casartar/LoRaWAN-Sensor/README.md

# Das LoRaWAN Sensor Projekt vom ZTL.space

[TTN](Documentation/TTN.md)

[Cayenne](Documentation/Cayenne.md)

[Assembly](Documentation/Assembly.md)
