casartar/LoRaWAN-Sensor/Documentation/Cayenne.md

# myDevices Cayenne Dashboard
[Cayenne Dashboard](https://cayenne.mydevices.com/)

1. Register

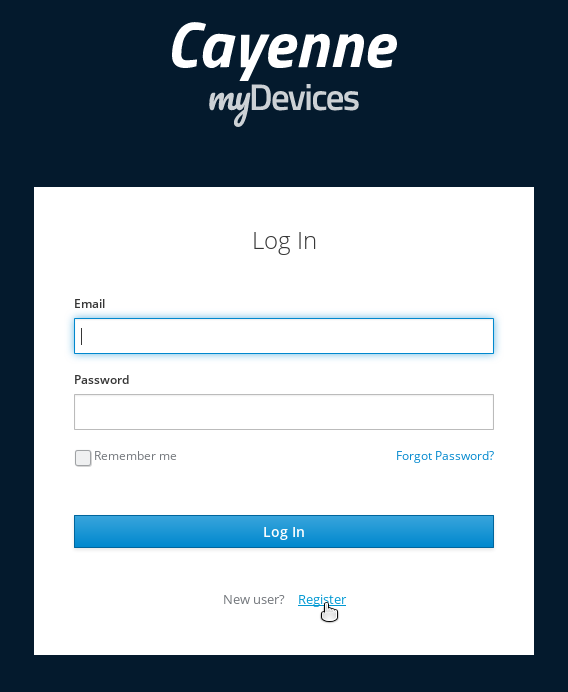
[picture p1: Documentation/Pictures_Cayenne/Screenshot_20201028_194106.png]
CAYENNE1


2. Vorname, Nachmane, Email-Adresse und Passwort vergeben. Mit Register bestätigen:

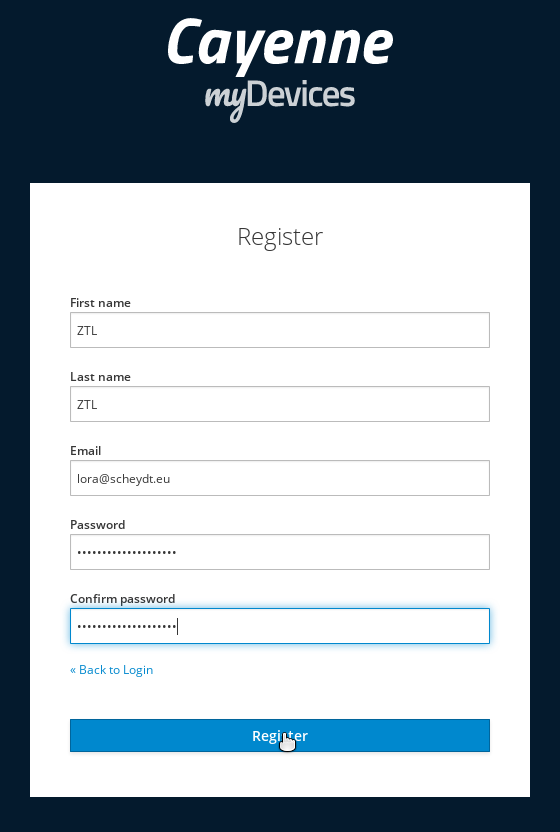
[picture p2: Documentation/Pictures_Cayenne/Screenshot_20201028_194218.png]
CAYENNE1


3. LoRA auswählen

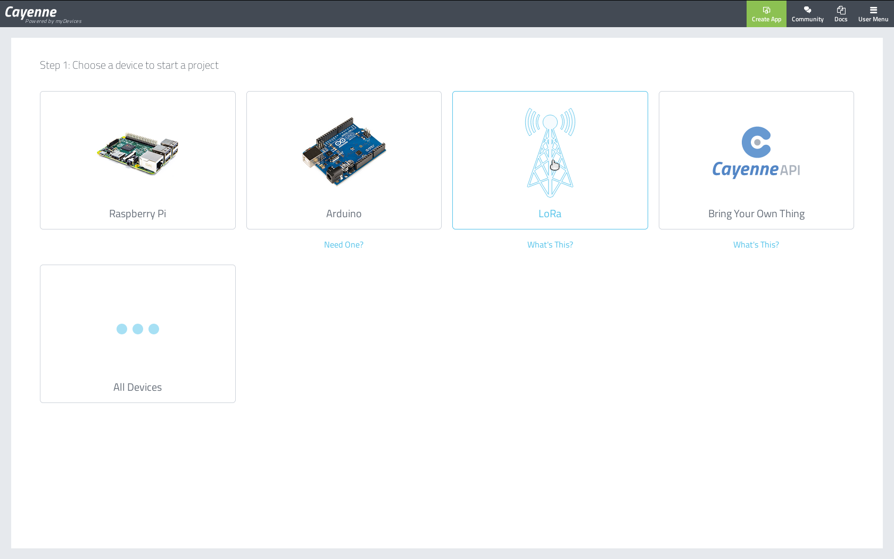
[picture p3: Documentation/Pictures_Cayenne/Screenshot_20201028_194320.png]
CAYENNE1


4. In der Liste links "The Thingnetwork" auswählen:

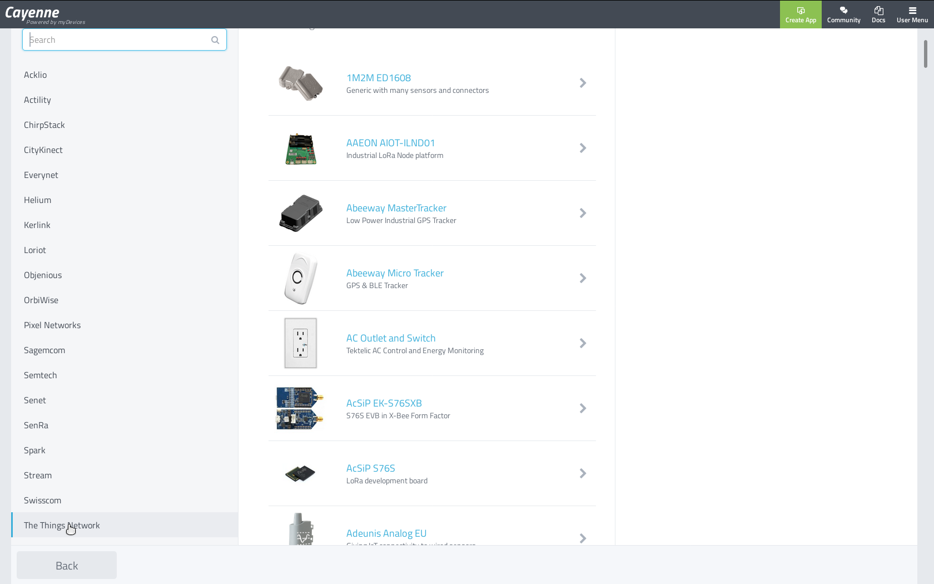
[picture p4: Documentation/Pictures_Cayenne/Screenshot_20201028_200921.png]
CAYENNE1


5. Dann nach "LPP" suchen und "Cayenne LPP" auswählen:

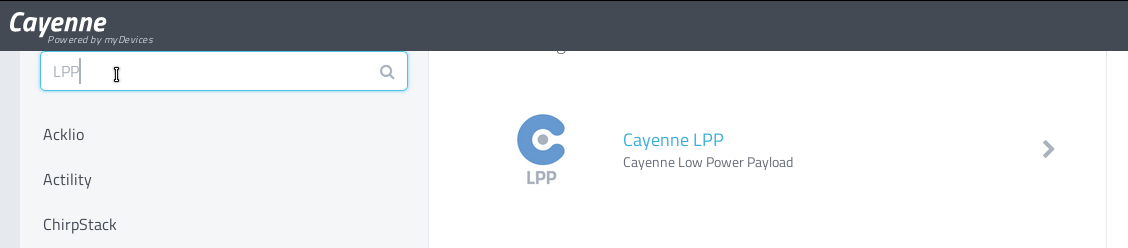
[picture p5: Documentation/Pictures_Cayenne/Screenshot_20201028_200932.png]
CAYENNE1


6. Aus dem TTN die Device EUI in hex format kopieren.

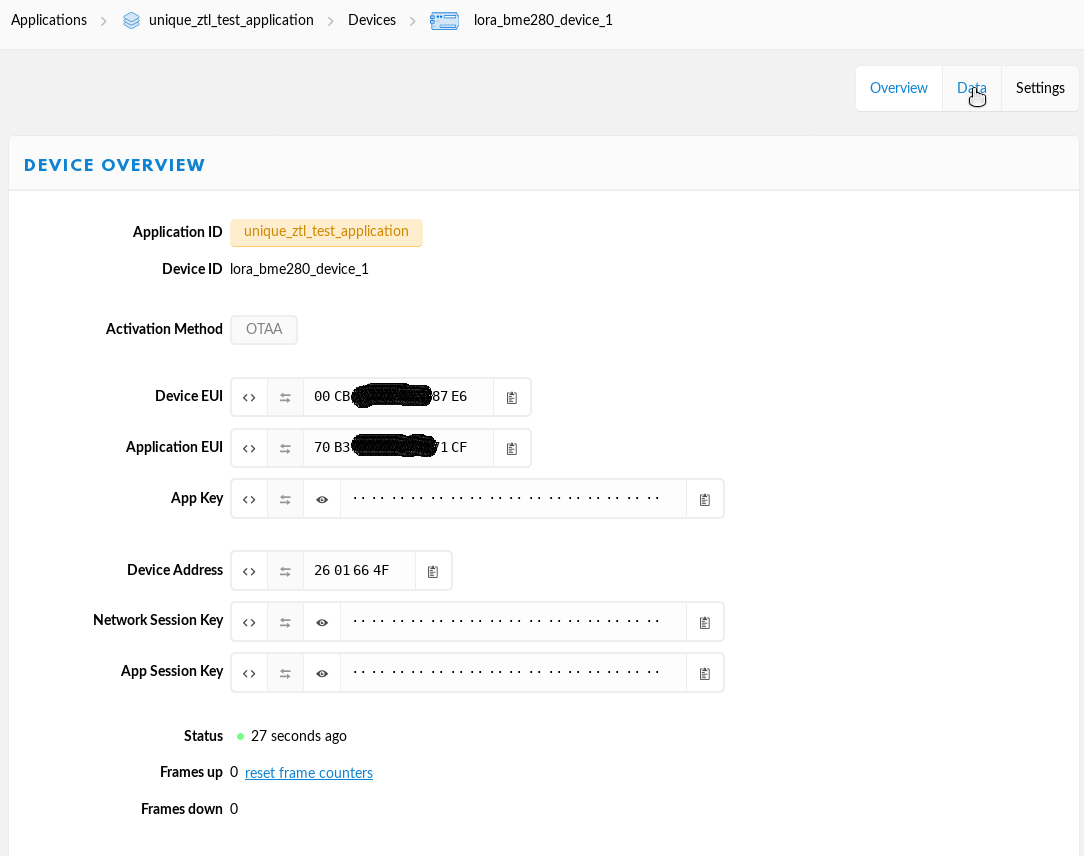
[picture p6: Documentation/Pictures_Cayenne/Screenshot_20201028_193343.png]
CAYENNE1


7. Name vergeben, die soeben kopierte Device EUI einfügen und Already Registered auswählen. Mit "Add device" bestätigen.

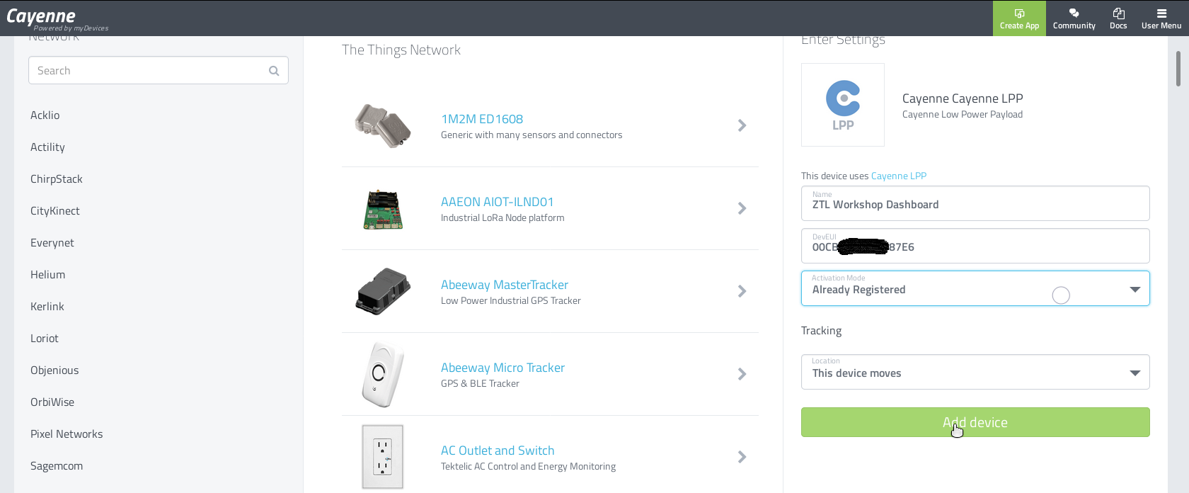
[picture p7: Documentation/Pictures_Cayenne/Screenshot_20201028_201020.png]
CAYENNE1


8. Sobald die ersten Daten empfangen werden, baut sich das Dashboard von selbst auf:

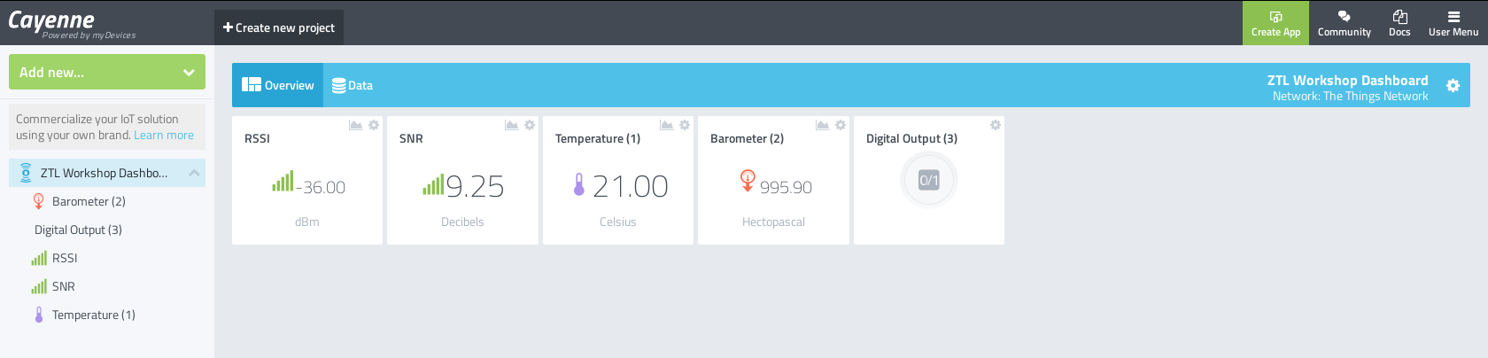
[picture p8: Documentation/Pictures_Cayenne/Screenshot_20201028_201038.png]
CAYENNE1


Mit einem Klick auf Digital Output kann die LED am Sensor aktiviert werden. Diese Information wird jedoch erst zum Sensor übertragen, nachdem dieser Seinerseits Daten übertragen hat.
