casartar/LoRaWAN-Sensor/Documentation/Pictures_Cayenne/Screenshot_20201028_200942.png

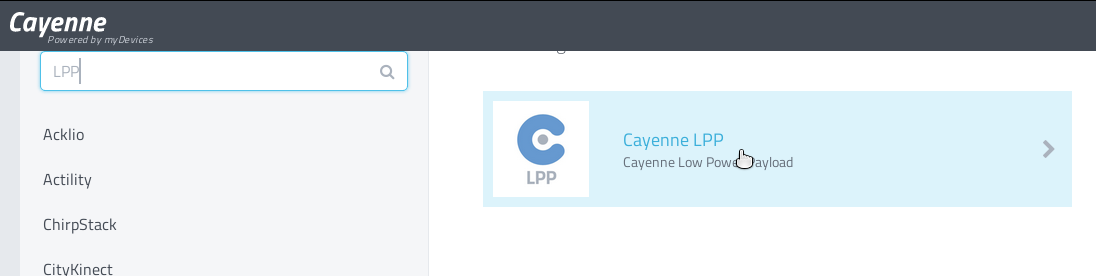
Documentation/Pictures_Cayenne/Screenshot_20201028_200942.png
