casartar/LoRaWAN-Sensor/Documentation/Pictures_TTN/Screenshot_20201028_191531.png

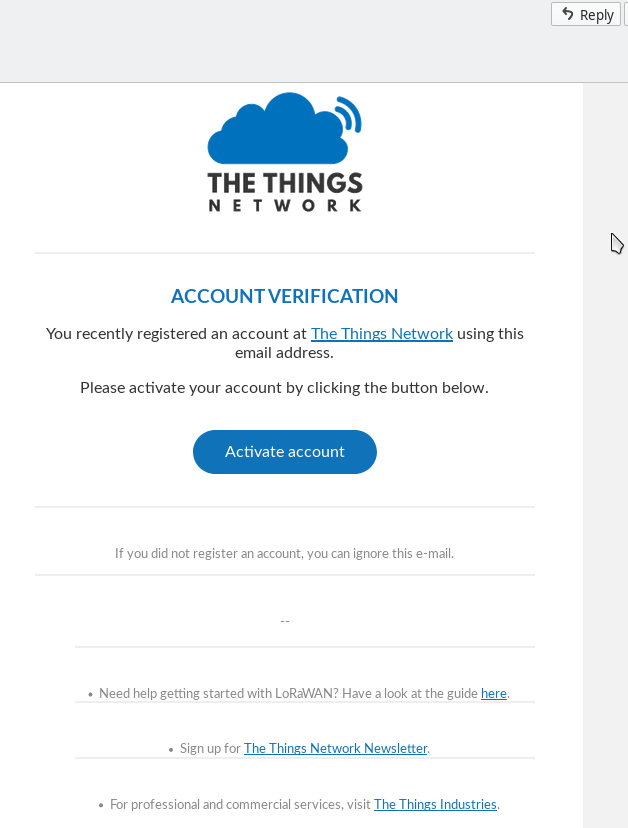
Documentation/Pictures_TTN/Screenshot_20201028_191531.png
