casartar/LoRaWAN-Sensor/Documentation/Pictures_TTN/Screenshot_20201028_193413.png

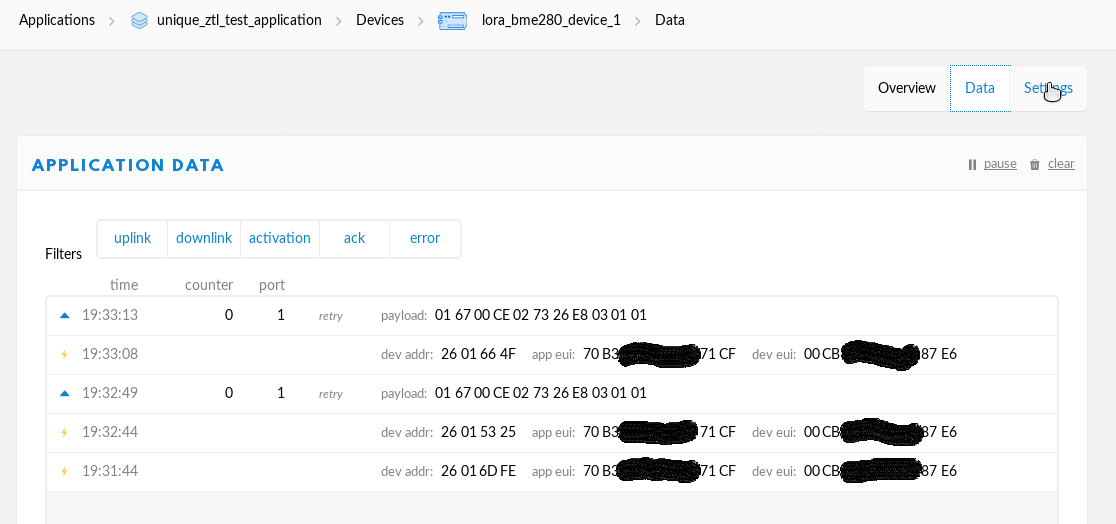
Documentation/Pictures_TTN/Screenshot_20201028_193413.png
