casartar/LoRaWAN-Sensor/3D-Models/LoRa-Baseplate.FCStd

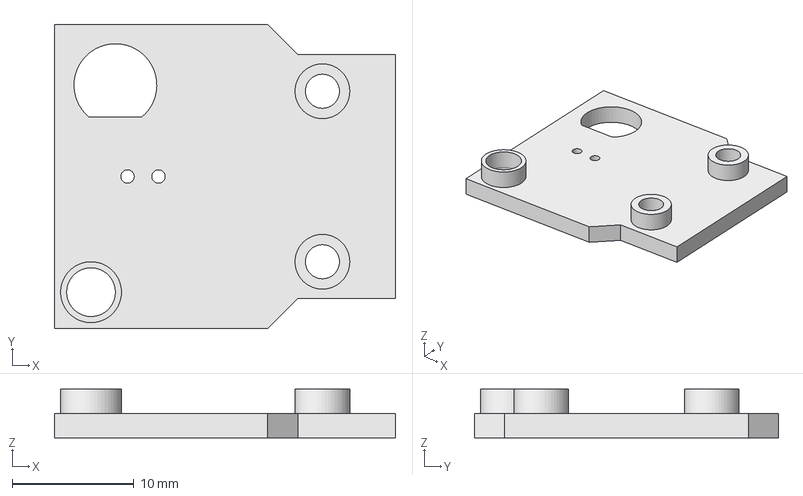
[picture p33: CAD file, 2020-11-08]
3D-Models/LoRa-Baseplate.FCStd
28.0 x 25.0 x 4.00 mm
