casartar/LoRaWAN-Sensor/(list of files, cad)

Other CAD files:
3D-Models/LoRa-Baseplate.stl
