casartar/LoRaWAN-Sensor/Documentation/Assembly.md

# Zusammenbau der Hardware

1. Alle Bauteile

* BME 280 mit Stiftleiste
*  Baseplate
*  WIFI LoRa 32 (V2) mit Stiftleisten
*  Pigtail
*  Antenne
*  LED
*  2x Unterlegscheiben M2
*  2x Schrauben M2 8 mm
*  1x Mutter M3
*  1x Schraube M3 8 mm
*  6x Jumper Kabel Female-Female

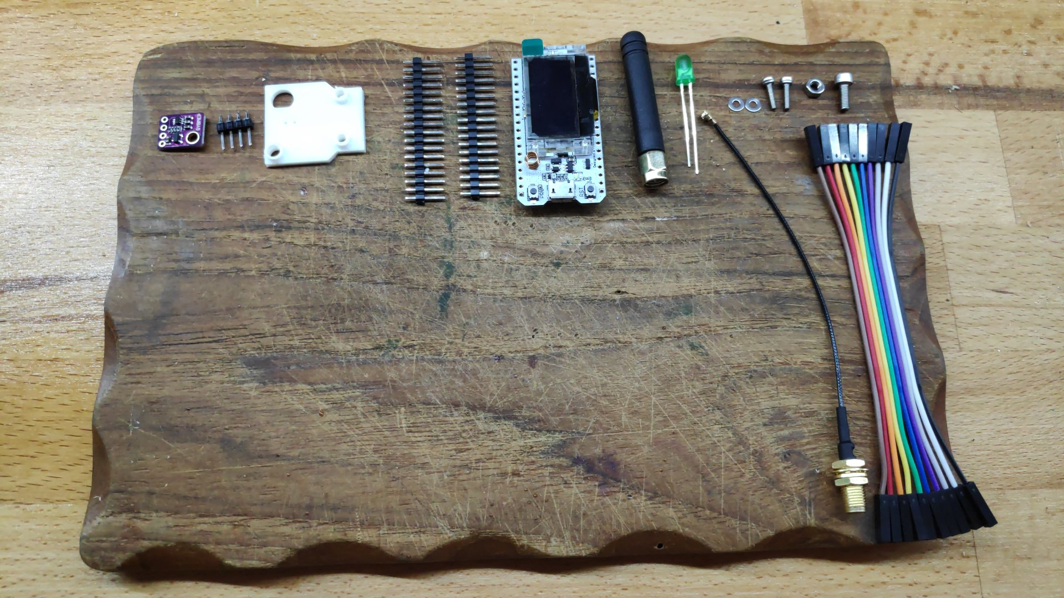
[picture p34: Documentation/Pictures_Assembly/IMG_20201108_200519.jpg]
ASSEMBLY


2. Beide Stifleisten an WIFI LoRa 32 (V2) anlöten.

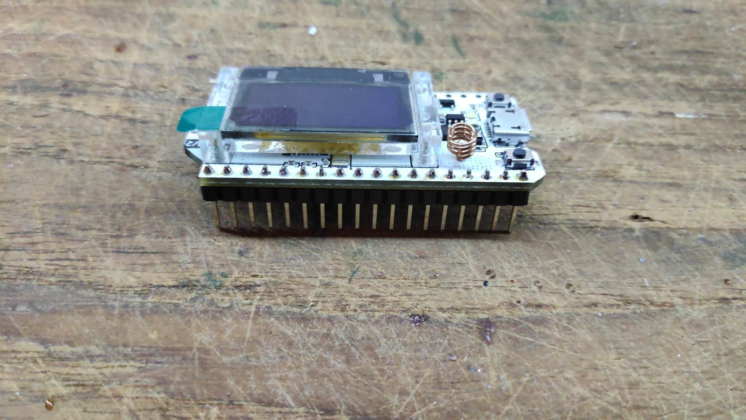
[picture p35: Documentation/Pictures_Assembly/IMG_20201108_200737.jpg]
ASSEMBLY


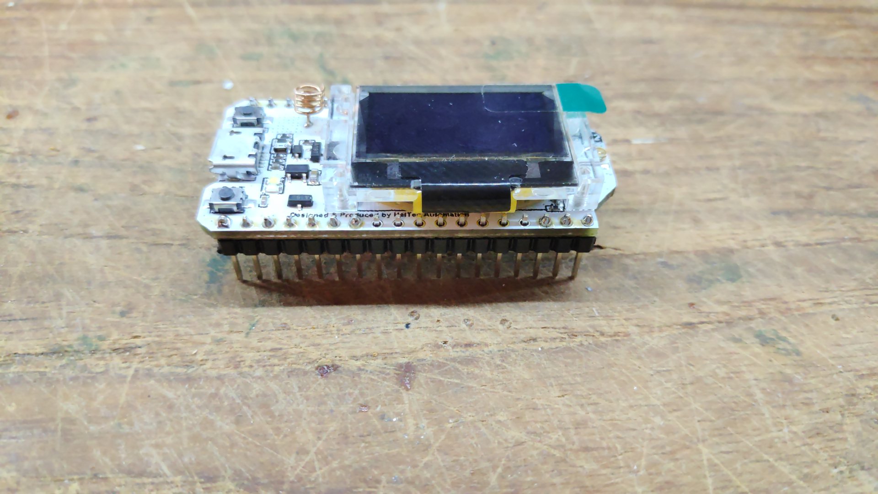
[picture p36: Documentation/Pictures_Assembly/IMG_20201108_200853.jpg]
ASSEMBLY


3. Zwei Schrauben für Displayhalterung entfernen.

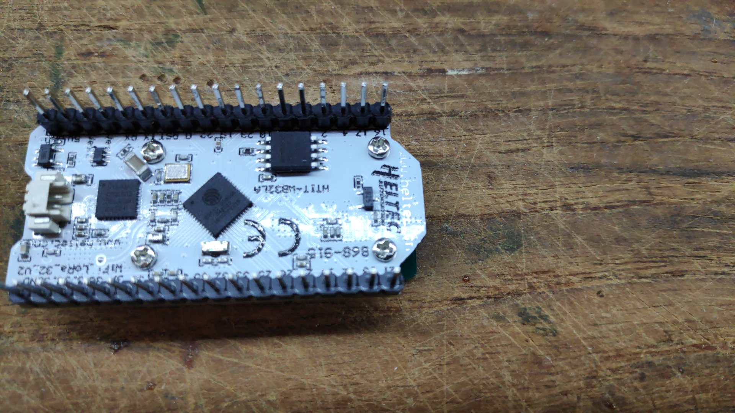
[picture p37: Documentation/Pictures_Assembly/IMG_20201108_201014.jpg]
ASSEMBLY


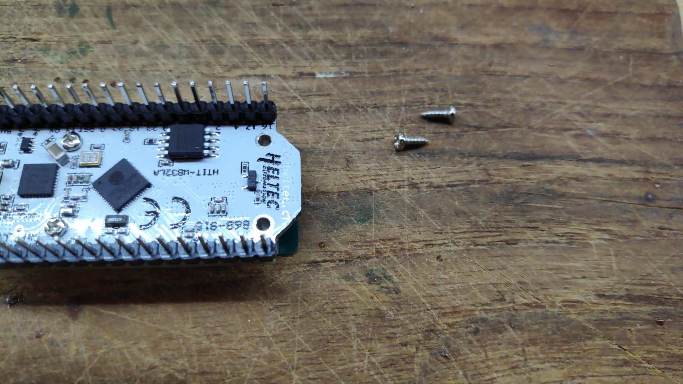
[picture p38: Documentation/Pictures_Assembly/IMG_20201108_201040.jpg]
ASSEMBLY


4. Baseplate mit M2 Schrauben und Unterlegscheiben fixieren. 

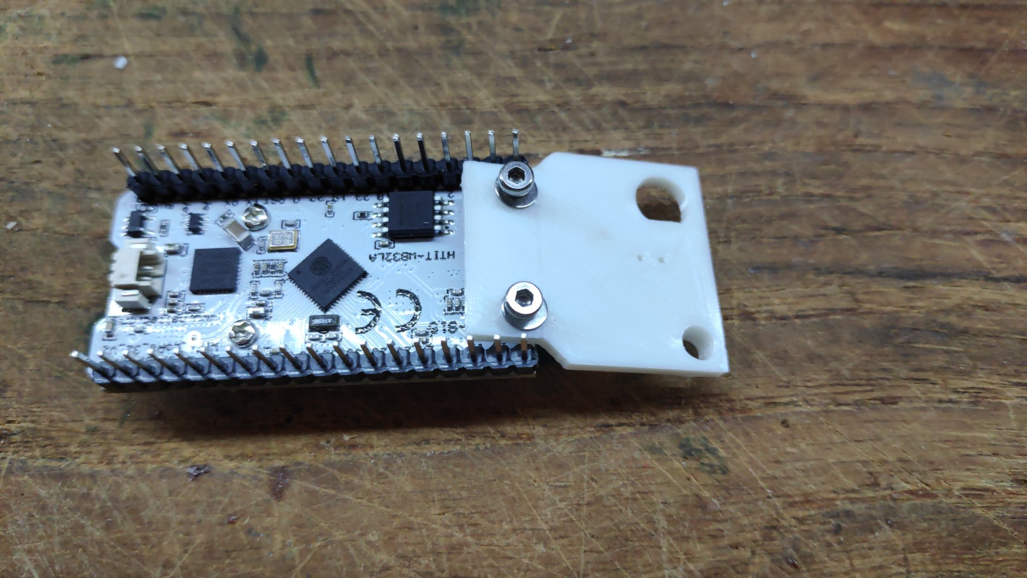
[picture p39: Documentation/Pictures_Assembly/IMG_20201108_201211.jpg]
ASSEMBLY


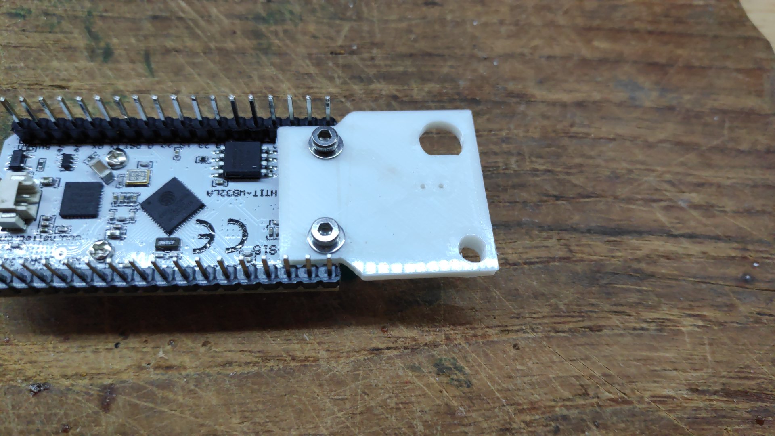
[picture p40: Documentation/Pictures_Assembly/IMG_20201108_201237.jpg]
ASSEMBLY


5. Stiftleiste an BME 280 anlöten.

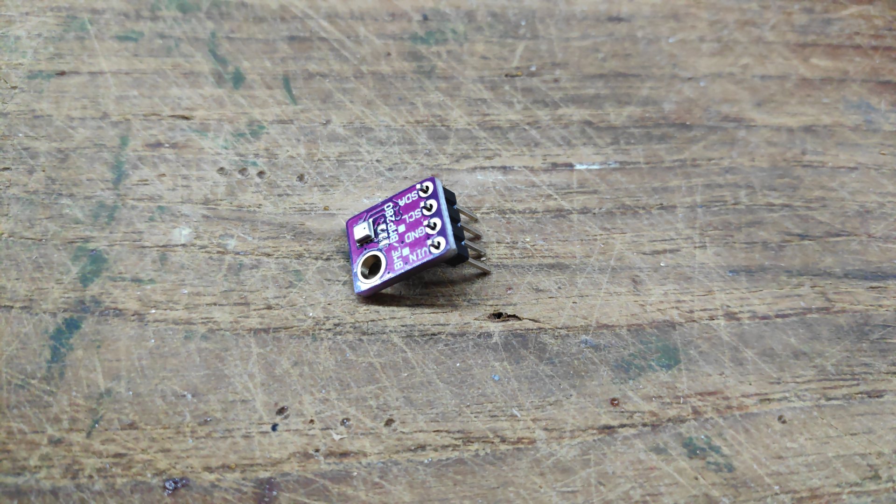
[picture p41: Documentation/Pictures_Assembly/IMG_20201108_201305.jpg]
ASSEMBLY


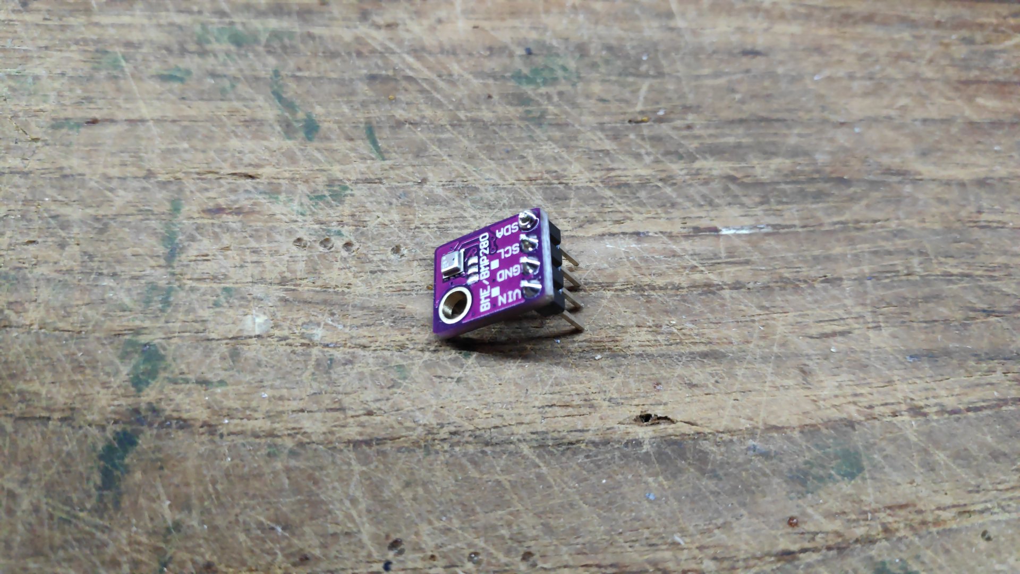
[picture p42: Documentation/Pictures_Assembly/IMG_20201108_201346.jpg]
ASSEMBLY


6. BME 280 mit M3 Schraube und Mutter fixieren.

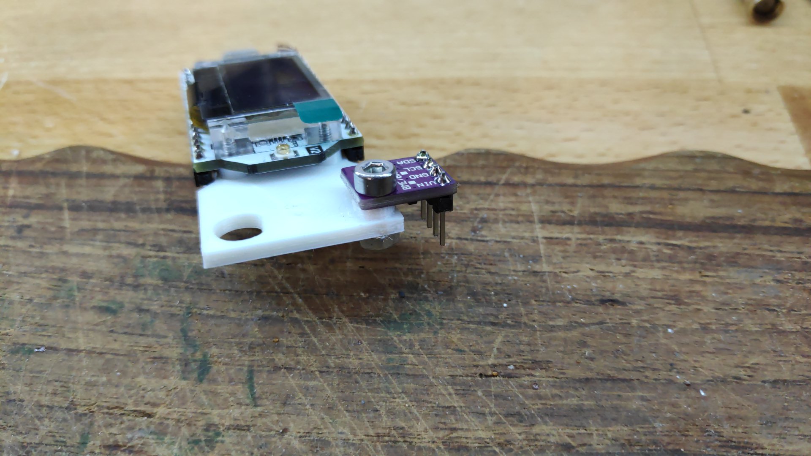
[picture p43: Documentation/Pictures_Assembly/IMG_20201108_201436.jpg]
ASSEMBLY


7. Pigtail an Baseplate festschrauben.

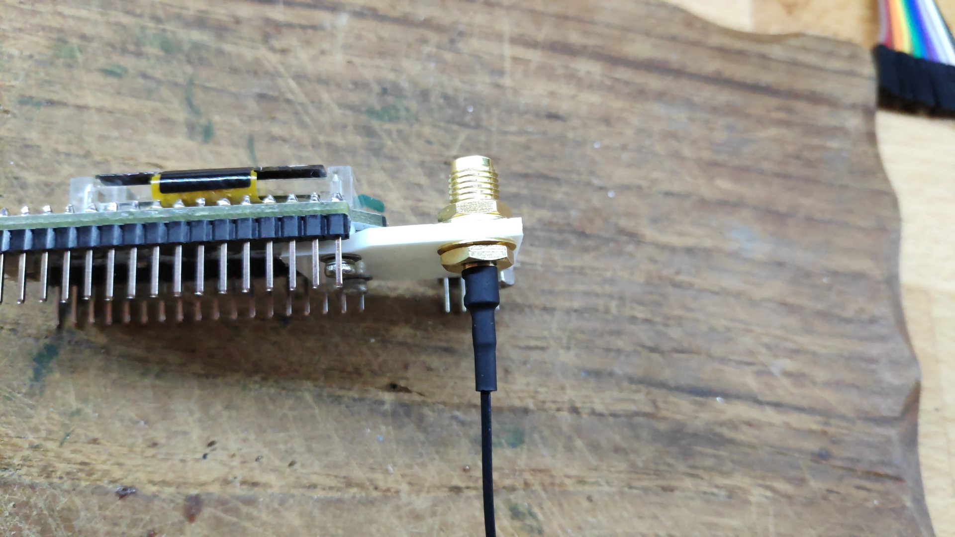
[picture p44: Documentation/Pictures_Assembly/IMG_20201108_201644.jpg]
ASSEMBLY


8. LED in Baseplate einstecken.

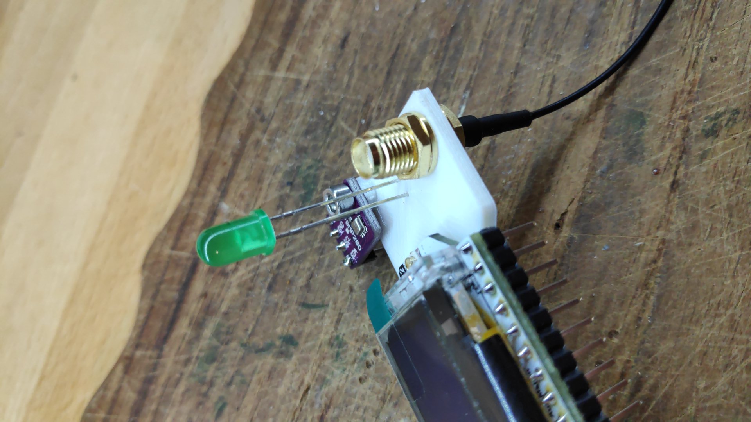
[picture p45: Documentation/Pictures_Assembly/IMG_20201108_201703.jpg]
ASSEMBLY


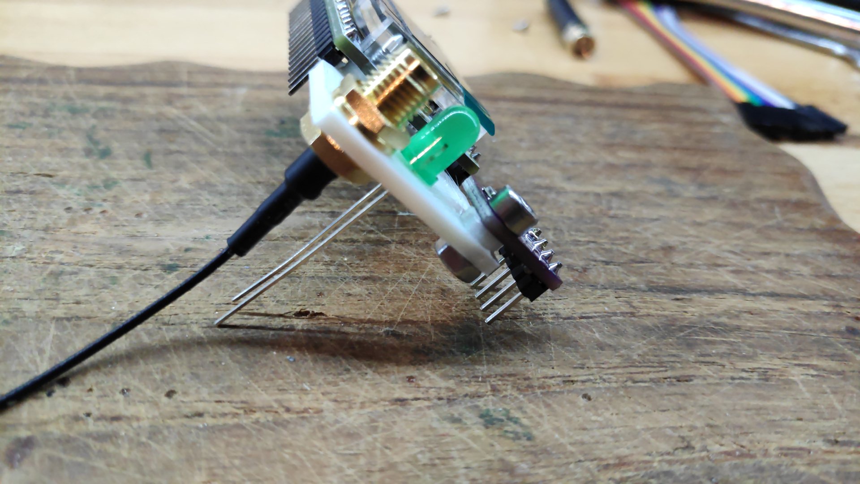
[picture p46: Documentation/Pictures_Assembly/IMG_20201108_201722.jpg]
ASSEMBLY


9. Pigtail an U.FL Stecker anschließen.

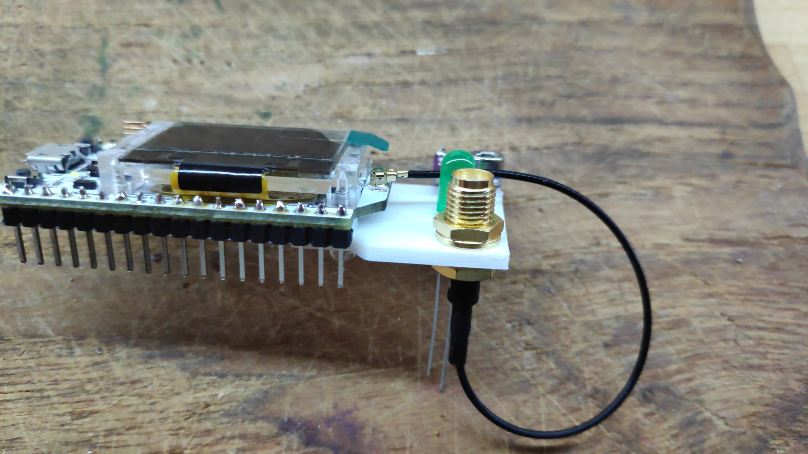
[picture p47: Documentation/Pictures_Assembly/IMG_20201108_201745.jpg]
ASSEMBLY


10. Mit Jumper Kabel LED verbinden

WIFI LoRa 32 (V2) | LED | Vorzugsfarbe
-------- | -------- | --------
Pin 17   | Anode (langer Pin)   | Orange
GND   | Kathode (kurzer Pin)   | Braun

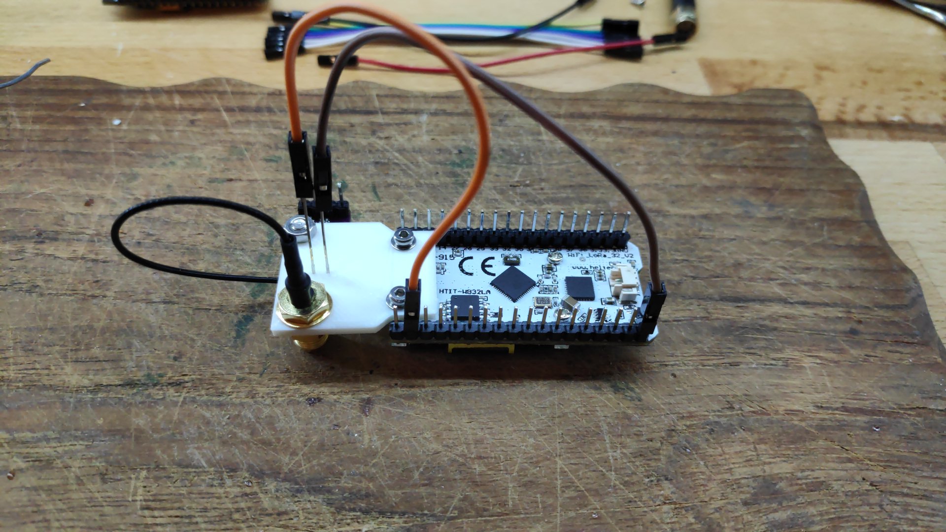
[picture p48: Documentation/Pictures_Assembly/IMG_20201108_201903.jpg]
ASSEMBLY


11. Mit Jumper Kabel BME 280 verbinden

WIFI LoRa 32 (V2) | BME280 | Vorzugsfarbe
-------- | -------- | --------
Pin 21   | SDA   | Blau
Pin 22   | SCL   | Gelb
3V3   | VIN   | Rot
GND   | GND   | Schwarz

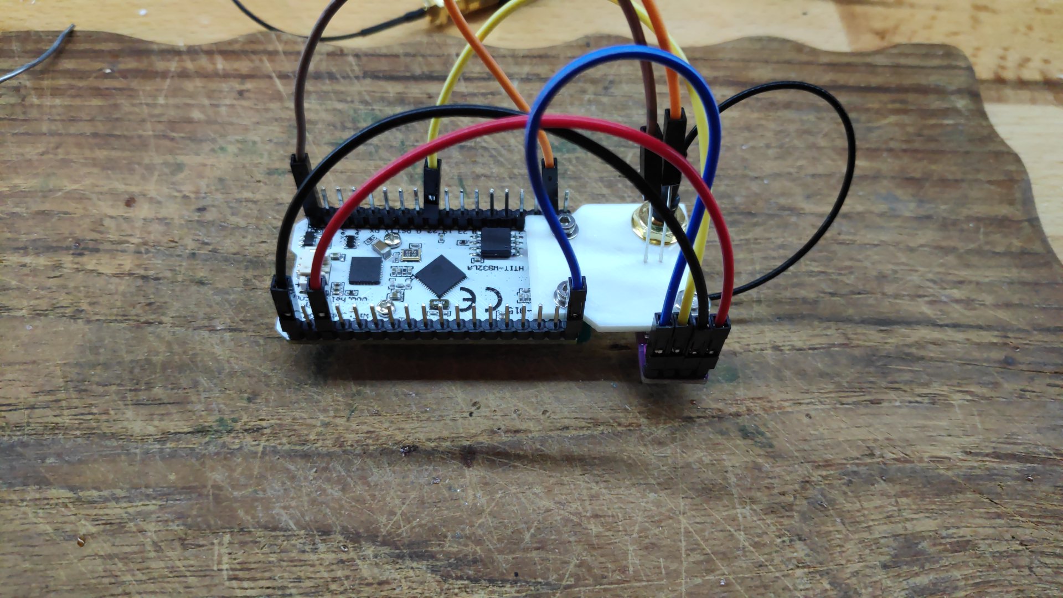
[picture p49: Documentation/Pictures_Assembly/IMG_20201108_202110.jpg]
ASSEMBLY


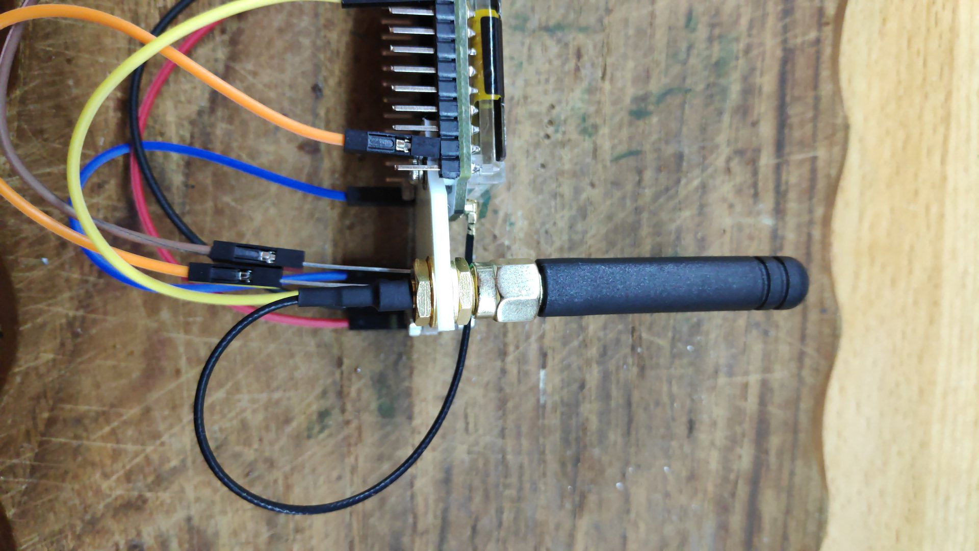
[picture p50: Documentation/Pictures_Assembly/IMG_20201108_202134.jpg]
ASSEMBLY
