casartar/LoRaWAN-Sensor/Documentation/Pictures_Assembly/IMG_20201108_200954.jpg

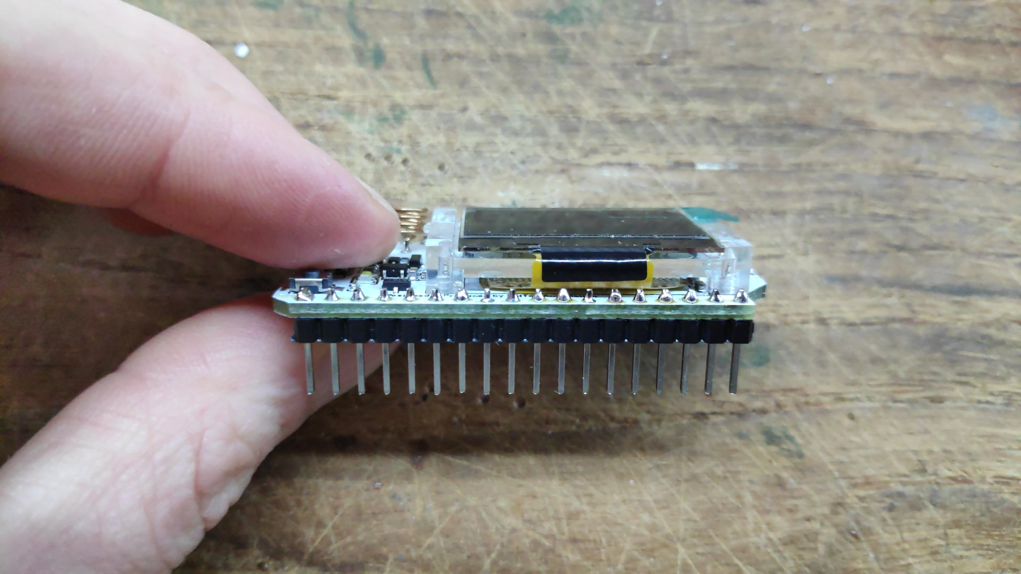
Documentation/Pictures_Assembly/IMG_20201108_200954.jpg
