casartar/LoRaWAN-Sensor/Firmware/src/main.cpp

/*******************************************************************************
 * Copyright (c) 2015 Thomas Telkamp and Matthijs Kooijman
 * Copyright (c) 2018 Terry Moore, MCCI
 *
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
 * This example sends a valid LoRaWAN packet with payload "Hello,
 * world!", using frequency and encryption settings matching those of
 * the The Things Network.
 *
 * This uses OTAA (Over-the-air activation), where where a DevEUI and
 * application key is configured, which are used in an over-the-air
 * activation procedure where a DevAddr and session keys are
 * assigned/generated for use with all further communication.
 *
 * Note: LoRaWAN per sub-band duty-cycle limitation is enforced (1% in
 * g1, 0.1% in g2), but not the TTN fair usage policy (which is probably
 * violated by this sketch when left running for longer)!

 * To use this sketch, first register your application and device with
 * the things network, to set or generate an AppEUI, DevEUI and AppKey.
 * Multiple devices can use the same AppEUI, but each device has its own
 * DevEUI and AppKey.
 *
 * Do not forget to define the radio type correctly in
 * arduino-lmic/project_config/lmic_project_config.h or from your BOARDS.txt.
 *
 *******************************************************************************/
#include <Arduino.h>

// LoRa
#include <lmic.h>
#include <hal/hal.h>
#include <SPI.h>

// BMP280
#include <Wire.h>
#include "Adafruit_BME280.h"

//CayenneLPP
#include <CayenneLPP.h>

// OLED
//#include <U8x8lib.h>
#include <U8g2lib.h>

#include "defines.h"

// This EUI must be in little-endian format, so least-significant-byte
// first. When copying an EUI from ttnctl output, this means to reverse
// the bytes. For TTN issued EUIs the last bytes should be 0xD5, 0xB3,
// 0x70.
static const u1_t PROGMEM APPEUI[8] = DEF_APPEUI;
void os_getArtEui (u1_t* buf) { memcpy_P(buf, APPEUI, 8);}

// This should also be in little endian format, see above.
static const u1_t PROGMEM DEVEUI[8] = DEF_DEVEUI;
void os_getDevEui (u1_t* buf) { memcpy_P(buf, DEVEUI, 8);}

// This key should be in big endian format (or, since it is not really a
// number but a block of memory, endianness does not really apply). In
// practice, a key taken from ttnctl can be copied as-is.
static const u1_t PROGMEM APPKEY[16] = DEF_APPKEY;
void os_getDevKey (u1_t* buf) {  memcpy_P(buf, APPKEY, 16);}

static osjob_t sendjob;

// Schedule TX every this many seconds (might become longer due to duty
// cycle limitations).
const unsigned TX_INTERVAL = 60;

// Pin mapping
const lmic_pinmap lmic_pins = {
    .nss = 18,
    .rxtx = LMIC_UNUSED_PIN,
    .rst = 14,
    .dio = {26, 35, 34},
};

#define I2C_SDA 21
#define I2C_SCL 22
#define SEALEVELPRESSURE_HPA (1013.25)
#define BME280_ADD 0x76

Adafruit_BME280 bme(I2C_SDA, I2C_SCL);

CayenneLPP lpp(51);

// OLED Pins
#define OLED_SCL 15   // GPIO 15
#define OLED_SDA  4   // GPIO  4
#define OLED_RST 16   // GPIO 16

// define the display type that we use
U8X8_SSD1306_128X64_NONAME_SW_I2C u8x8(/* clock=*/ OLED_SCL, /* data=*/ OLED_SDA, /* reset=*/ OLED_RST);

void do_send(osjob_t* j);

void printHex2(unsigned v) {
    v &= 0xff;
    if (v < 16)
        Serial.print('0');
    Serial.print(v, HEX);
}

void onEvent (ev_t ev) {
    Serial.print(os_getTime());
    Serial.print(": ");
    switch(ev) {
        case EV_SCAN_TIMEOUT:
            Serial.println(F("EV_SCAN_TIMEOUT"));
            break;
        case EV_BEACON_FOUND:
            Serial.println(F("EV_BEACON_FOUND"));
            break;
        case EV_BEACON_MISSED:
            Serial.println(F("EV_BEACON_MISSED"));
            break;
        case EV_BEACON_TRACKED:
            Serial.println(F("EV_BEACON_TRACKED"));
            break;
        case EV_JOINING:
            Serial.println(F("EV_JOINING"));
            break;
        case EV_JOINED:
            Serial.println(F("EV_JOINED"));
            {
              u4_t netid = 0;
              devaddr_t devaddr = 0;
              u1_t nwkKey[16];
              u1_t artKey[16];
              LMIC_getSessionKeys(&netid, &devaddr, nwkKey, artKey);
              Serial.print("netid: ");
              Serial.println(netid, DEC);
              Serial.print("devaddr: ");
              Serial.println(devaddr, HEX);
              Serial.print("AppSKey: ");
              for (size_t i=0; i<sizeof(artKey); ++i) {
                if (i != 0)
                  Serial.print("-");
                printHex2(artKey[i]);
              }
              Serial.println("");
              Serial.print("NwkSKey: ");
              for (size_t i=0; i<sizeof(nwkKey); ++i) {
                      if (i != 0)
                              Serial.print("-");
                      printHex2(nwkKey[i]);
              }
              Serial.println();
            }
            // Disable link check validation (automatically enabled
            // during join, but because slow data rates change max TX
	    // size, we don't use it in this example.
            LMIC_setLinkCheckMode(0);
            break;
        /*
        || This event is defined but not used in the code. No
        || point in wasting codespace on it.
        ||
        || case EV_RFU1:
        ||     Serial.println(F("EV_RFU1"));
        ||     break;
        */
        case EV_JOIN_FAILED:
            Serial.println(F("EV_JOIN_FAILED"));
            break;
        case EV_REJOIN_FAILED:
            Serial.println(F("EV_REJOIN_FAILED"));
            break;
        case EV_TXCOMPLETE:
            Serial.println(F("EV_TXCOMPLETE (includes waiting for RX windows)"));
            if (LMIC.txrxFlags & TXRX_ACK)
                Serial.println(F("Received ack"));
            if (LMIC.dataLen) {
                Serial.print(F("Received "));
                Serial.print(LMIC.dataLen);
                Serial.println(F(" bytes of payload"));
                for (uint8_t i = 0; i < LMIC.dataLen; i++) {
                    char buffer[6];
                    sprintf(buffer, "0x%02x ", LMIC.frame[LMIC.dataBeg + i]);
                    Serial.print(buffer);
                }
                Serial.println("");
                if (LMIC.frame[LMIC.dataBeg + 0] == 0x03
                 && LMIC.frame[LMIC.dataBeg + 1] == 0x00) {
                    if (LMIC.frame[LMIC.dataBeg + 2] == 0x64) {
                        digitalWrite(17, HIGH);
                    }
                    else if (LMIC.frame[LMIC.dataBeg + 2] == 0x00) {
                        digitalWrite(17, LOW);
                    }
                }
            }
            // Schedule next transmission
            os_setTimedCallback(&sendjob, os_getTime()+sec2osticks(TX_INTERVAL), do_send);
            break;
        case EV_LOST_TSYNC:
            Serial.println(F("EV_LOST_TSYNC"));
            break;
        case EV_RESET:
            Serial.println(F("EV_RESET"));
            break;
        case EV_RXCOMPLETE:
            // data received in ping slot
            Serial.println(F("EV_RXCOMPLETE"));
            break;
        case EV_LINK_DEAD:
            Serial.println(F("EV_LINK_DEAD"));
            break;
        case EV_LINK_ALIVE:
            Serial.println(F("EV_LINK_ALIVE"));
            break;
        /*
        || This event is defined but not used in the code. No
        || point in wasting codespace on it.
        ||
        || case EV_SCAN_FOUND:
        ||    Serial.println(F("EV_SCAN_FOUND"));
        ||    break;
        */
        case EV_TXSTART:
            Serial.println(F("EV_TXSTART"));
            break;
        case EV_TXCANCELED:
            Serial.println(F("EV_TXCANCELED"));
            break;
        case EV_RXSTART:
            /* do not print anything -- it wrecks timing */
            break;
        case EV_JOIN_TXCOMPLETE:
            Serial.println(F("EV_JOIN_TXCOMPLETE: no JoinAccept"));
            break;

        default:
            Serial.print(F("Unknown event: "));
            Serial.println((unsigned) ev);
            break;
    }
}

void do_send(osjob_t* j){
    // Check if there is not a current TX/RX job running
    if (LMIC.opmode & OP_TXRXPEND) {
        Serial.println(F("OP_TXRXPEND, not sending"));
    } else {
        // Prepare upstream data transmission at the next possible time.

        char buffer[255];
        float temperature = bme.readTemperature();
        sprintf(buffer, "Temperature: %10.2f degC Raw: %5d | 0x%04x\r\n", temperature, (int16_t)(temperature), (int16_t)(temperature));
        Serial.print(buffer);
        u8x8.drawString(0, 2, "Temperature:");
        sprintf(buffer, "%.2f degC", temperature);
        u8x8.drawString(0, 3, buffer);

        float pressure = bme.readPressure();        
        sprintf(buffer, "Pressure:    %10.2f Pa   Raw: %5d | 0x%04x\r\n", pressure, (uint16_t)(pressure/100), (uint16_t)(pressure/100));
        Serial.print(buffer);
        u8x8.drawString(0, 5, "Pressure:");
        sprintf(buffer, "%.2f Pa", pressure);
        u8x8.drawString(0, 6, buffer);

        lpp.reset();
        lpp.addTemperature(1, temperature);
        lpp.addBarometricPressure(2, pressure/100);
        lpp.addDigitalOutput(3, 1);

        LMIC_setTxData2(1, lpp.getBuffer(), lpp.getSize(), 0);
        Serial.println(F("Packet queued"));
    }
    // Next TX is scheduled after TX_COMPLETE event.
}

void setup() {
    Serial.begin(115200);
    Serial.println(F("Starting"));

    // Set LED to output
    pinMode(17, OUTPUT);

    // set up the display
    u8x8.begin();
    u8x8.setPowerSave(0);
    u8x8.setFont(u8x8_font_chroma48medium8_r);
    u8x8.drawString(0, 0, "BME280 Soldier 1");

    bool status;
    status = bme.begin(BME280_ADD);
    if (!status) {
        Serial.println("Could not find a valid BME280 sensor, check wiring!");
        while (1);
    }

    // LMIC init
    os_init();
    // Reset the MAC state. Session and pending data transfers will be discarded.
    LMIC_reset();

    // Start job (sending automatically starts OTAA too)
    do_send(&sendjob);
}

void loop() {
    os_runloop_once();
}
