casartar/LoRaWAN-Sensor/(commit log)

2020-10-25 LED added
2020-11-08 Baseplate added
    [LoRa-Baseplate.FCStd, LoRa-Baseplate.stl]
2020-11-08 curly brackets removed
2020-11-08 Picures for Assembly added
2020-11-08 Changed pin settings for Heltec Wifi LoRa 32 V2 https://www.thethingsnetwork.org/forum/t/big-esp32-sx127x-topic-part-3/18436
2020-11-15 Documentation for Assembly added
